chocochip119/wifi-csi-project/docs/members/README.md

# 팀원 기록

`member1.md`부터 `member7.md`까지는 역할/설계 메모/진행 상황을 적는 기존 템플릿입니다. 파일에 실명과 담당이 확정되어 있지 않아 이번 구조 정리에서 번호별 역할이나 완료 상태를 임의로 채우지 않았습니다.

| 템플릿 | 현재 상태 |
|---|---|
| [Member 1](member1.md) | 담당 미기입 |
| [Member 2](member2.md) | 담당 미기입 |
| [Member 3](member3.md) | 담당 미기입 |
| [Member 4](member4.md) | 담당 미기입 |
| [Member 5](member5.md) | 담당 미기입 |
| [Member 6](member6.md) | 담당 미기입 |
| [Member 7](member7.md) | 담당 미기입 |

각 기록에는 실제 작업 경로, PR/commit, 수행한 테스트와 남은 확인 항목을 함께 적습니다. 공통 시스템/규격은 [문서 목록](../README.md)에서 참조하고 팀원 문서마다 같은 구조 그림을 반복하지 않습니다. 현재 코드별 역할은 [저장소 구조](../repository_structure.md)를 참고하세요.
