chocochip119/wifi-csi-project/docs/members/member1.md

# Member 1

## 담당
- TBD

## 조사 / 설계 메모
-

## 진행 상황
- [ ] 담당 확정
- [ ] 입력/출력 정의
- [ ] 구현
- [ ] 검증

## 이슈 / TODO
-
