chocochip119/wifi-csi-project/docs/assets/presentation-pose-reference.jpg

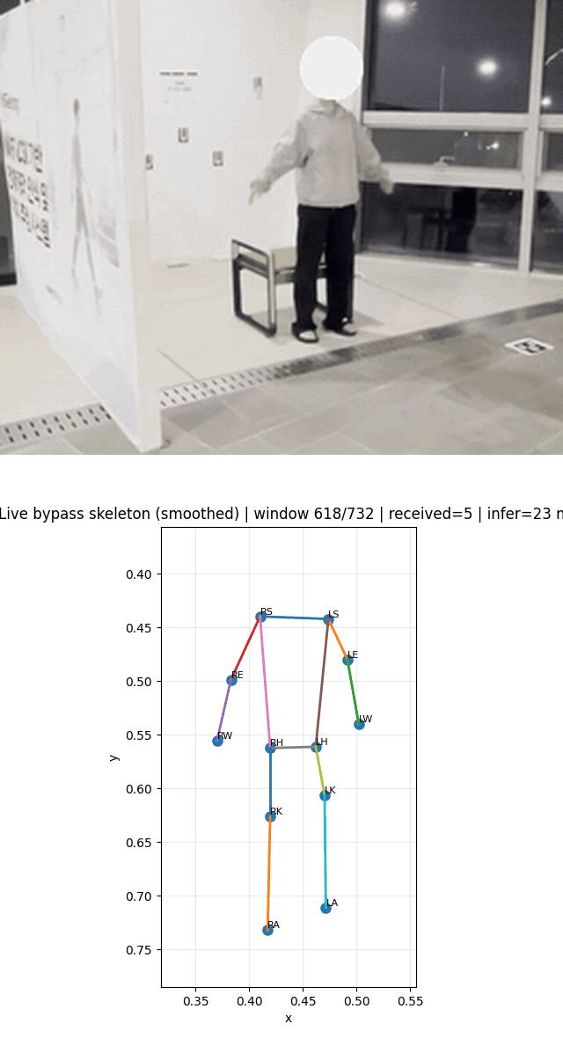
docs/assets/presentation-pose-reference.jpg
