chocochip119/wifi-csi-project/ml/localization/results/run_20261008_091144_37cf3fcf/knn_per_point_metrics.csv

point | precision | recall
p01 | 1.0 | 1.0
p02 | 0.9 | 1.0
p03 | 1.0 | 0.3333333333333333
p04 | 1.0 | 0.9315068493150684
p05 | 0.6956521739130435 | 0.64
p06 | 0.9827586206896551 | 0.7702702702702703
p07 | 0.9230769230769231 | 1.0
p08 | 0.9864864864864865 | 1.0
p09 | 0.5 | 1.0
p10 | 0.8548387096774194 | 0.7162162162162162
empty | 0.8409090909090909 | 1.0
