chocochip119/wifi-csi-project/ml/localization/results/run_20261008_091144_37cf3fcf/mlp_per_point_metrics.csv

point | precision | recall
p01 | 1.0 | 1.0
p02 | 0.9113924050632911 | 1.0
p03 | 0.8181818181818182 | 0.75
p04 | 1.0 | 1.0
p05 | 0.6578947368421053 | 1.0
p06 | 1.0 | 0.43243243243243246
p07 | 1.0 | 1.0
p08 | 0.9240506329113924 | 1.0
p09 | 0.40625 | 1.0
p10 | 1.0 | 0.7027027027027027
empty | 0.9736842105263158 | 1.0
