chocochip119/wifi-csi-project/ml/localization/results/run_20261008_091144_37cf3fcf/knn_confusion_matrix.csv

truth | p01 | p02 | p03 | p04 | p05 | p06 | p07 | p08 | p09 | p10 | empty
p01 | 24 | 0 | 0 | 0 | 0 | 0 | 0 | 0 | 0 | 0 | 0
p02 | 0 | 72 | 0 | 0 | 0 | 0 | 0 | 0 | 0 | 0 | 0
p03 | 0 | 0 | 8 | 0 | 0 | 0 | 2 | 1 | 13 | 0 | 0
p04 | 0 | 0 | 0 | 68 | 4 | 1 | 0 | 0 | 0 | 0 | 0
p05 | 0 | 0 | 0 | 0 | 16 | 0 | 0 | 0 | 0 | 9 | 0
p06 | 0 | 0 | 0 | 0 | 0 | 57 | 0 | 0 | 13 | 0 | 4
p07 | 0 | 0 | 0 | 0 | 0 | 0 | 24 | 0 | 0 | 0 | 0
p08 | 0 | 0 | 0 | 0 | 0 | 0 | 0 | 73 | 0 | 0 | 0
p09 | 0 | 0 | 0 | 0 | 0 | 0 | 0 | 0 | 26 | 0 | 0
p10 | 0 | 8 | 0 | 0 | 3 | 0 | 0 | 0 | 0 | 53 | 10
empty | 0 | 0 | 0 | 0 | 0 | 0 | 0 | 0 | 0 | 0 | 74
