chocochip119/wifi-csi-project/(commit log)

2026-09-15 fix: update ESP-TX IDF config and Wi-Fi bandwidth
    [main.c]
2026-09-25 feat(cnn): add CNN Encoder RTL
    Conv_MAC (16-lane, Conv1/Conv2 sequencer), requant_stage, gelu_stage,
    Pool (AdaptiveAvgPool 8x4 + requant), Buffer, and CNN_Encoder top.
    enc_start runs RX0 -> RX1 -> RX2; Pool result is stored at
    rx*1024 + oc*32 + oh*4 + ow.
2026-09-25 feat(cnn): add CNN Encoder testbenches and timescale
    - Add `timescale 1ns / 1ps to Pool.v and gelu_stage.v (Buffer.v already had it)
    - Add testbenches under pl/cnn/testbench/CNN_Encoder:
    tb_requant_stage (5,000 vectors), tb_Conv_MAC (184,320 acc outputs, 3 RX),
    tb_CNN_Encoder (full Conv1 -> Conv2 -> Pool, 3,072 B vs int8 reference)
    - Python vector generators follow ML/src/int8_reference.py rounding rules
2026-09-26 feat(cnn): add Flatten and FC FIFO RTL
    - Add Flatten interface between CNN Encoder output and FC module
    - Add 64-bit read path for FC activation data
    - Add FC FIFO for buffering activation data
    - Define fixed 1-cycle read latency between Flatten and FC
    [fc_fifo.v, flatten.v]
2026-09-29 fix(cnn): make Buffer infer BRAM for 64-bit write / 8-bit read
    Address the narrow cells as {waddr, lsb} instead of waddr * RATIO + i so
    Vivado recognizes one wide-port write (UG901 asymmetric RAM template).
    The old form was seen as RATIO independent write ports and failed with
    [Synth 8-3391]. Old code is kept as a comment.
    [Buffer.v]
2026-09-29 fix(cnn): add pipeline to fix timing slack
    Split long combinational paths so CNN_Encoder meets 100 MHz
    (XC7Z010, OOC place & route: WNS -2.99 ns -> +0.109 ns).
    - requant_stage: round shift | saturate
    - Pool: round shift | saturate, /48 (dq) | sign + clamp
    - Conv_MAC: 8x8 multiply (prod_r) | accumulate, add s3 tap stage
    Results are unchanged (tb_Conv_MAC, tb_CNN_Encoder pass); only latency
    increases, and valid/tag are delayed with the data.
    [Conv_MAC.v, Pool.v, requant_stage.v]
2026-09-29 docs: simplify README for current project scope
2026-09-29 fix: resolve FC pipeline review issues
    - Fix FC parameter addressing to use acc_tag
    - Correct negative requantization rounding
    - Reject invalid fc_sel values in FC controller
    [fc_controller.v, fc_top.v, requant_core.v]
2026-09-29 feat(cnn): parameterize CNN Encoder by number of receivers (RX)
    - CNN_Encoder: parameter RX (default 5); input buffer size, in_waddr,
    feat_raddr and tag width are derived from RX
    - Conv_MAC: rx counter width, last-RX check, input channel = rx + RX*ic
    - Pool: tag rx field, result memory RX*128 words, enc_done at rx == RX-1
    - requant_stage, gelu_stage: TAG_W parameter (tag is passed through)
    - Comments translated to English
    - tb_CNN_Encoder / gen_CNN_Encoder.py take RX; verified for RX = 1..5
    (tb_Conv_MAC, tb_requant_stage unchanged and still pass)
2026-09-29 fix: RX 지원 범위 제한 및 reset 방식 통일
    [pose_cnn.v, pose_cnn_ctrl.v]
2026-09-29 refactor: Loader RTL 디렉터리 구조 정리
2026-10-04 feat: stabilize ESP-TX timing and add 6-person training notebooks
    - set default Wi-Fi channel to 9
    - improve TX timeout and cycle pacing handling
    - add USB control age limit
    - add 6-person 5RX training notebooks
    [main.c]
2026-10-04 fix: address TX and FPGA export review issues
    - count only stale cycle frames as USB cycle drops
    - fix training notebook stride description
    - pin reference repository commit for reproducibility
    - validate exact FPGA weight blob region sizes
    [main.c]
2026-10-06 fix: correct requantization shift and pipeline handling
    - align requant parameters with accumulator pipeline
    - widen intermediate signals to prevent signed overflow
    - handle signed shift and saturation safely
    - preserve tag and valid timing through pipeline
    [requant_core.v]
2026-10-06 fix: align FC requant params and signed rounding
    [requant_core.v]
2026-10-06 fix: sync packaged requant core implementation
    [requant_core.v]
2026-10-07 fix: align requant parameters and rounding
    [requant_core.v]
2026-10-07 UDP
    pc로 udp 통신이 가능하게 ps 코드를 수정함
2026-10-07 Pin Colab to corrected INT8 reference and add reproducible golden checks
    [run_regression.py]
2026-10-07 파일 정리
2026-10-08 feat(localization): add location model training code and update backend model (#35)
    * feat(localization): add location ML code, rename to location_*, update model to 10/08 run
    - ml/localization: 11-class location training/eval code, notebook (outputs cleared), 60 unit tests,
    setup scripts, live check GUI (USB) + tools/csi_live_gui_ethernet.py (PS TCP 5000)
    - export_portable_model.py: run -> pc/backend npz/json + fixture; npz == sklearn on all 563 validation windows
    - pc/backend: fivepoint_{core,live,model} -> location_* (imports only)
    - pc/backend model: run_20261008_091144_37cf3fcf (Ridge, val BA 0.962); fixture covers all 11 classes
    - pc/backend/tools/replay_ps_server.py: fake PS replay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
    [knn_confusion_matrix.csv, knn_per_point_metrics.csv, leaderboard.csv, mlp_confusion_matrix.csv, mlp_per_point_metrics.csv, ridge_confusion_matrix.csv, ridge_per_point_metrics.csv]
2026-10-09 feat(frontend): expose side camera and pose mirror adjustments in settings
2026-10-09 Fix typo in RUN_README.md regarding thread usage
2026-10-09 fix(frontend): initialize launcher exit button after rendering main screen
2026-10-10 feat: WiSensing LIVE 위치/모션 모드와 관리자 진단 v18
    * feat(frontend): add live center/follow switching and location/pose admin metrics
    * fix(frontend): sync center/follow buttons on all LIVE reset
2026-10-10 feat: WiSensing 통합 관리자 및 실시간 12관절-캐릭터 연동
    * feat(frontend): enable live leg pose tracking by default
    * feat(frontend): unify pose input for skeleton and 3D rig; open administrator
    * feat(frontend): add 16 editable 12-joint pose presets and interpolation utilities
    * feat(admin): live/test pose editor with dragging, keyframes, replay and JSON IO
    * feat(admin): integrate live status, joint editing controls and 3D preview
    * fix(admin): show interpreted joint angles and support arbitrary real CNN coordinate scale
2026-10-10 feat: WiSensing 인체 구조 기반 2-Bone IK 및 앉기/몸통 보정
    * feat(ik): add reusable human joint constraints and seated-depth geometry
    * feat(rig): anatomical planted-seat IK, stable body offsets and chest-aware arm correction
    * feat(admin): expose anatomical IK calibration and 3D telemetry
    * fix(rig): smooth first chest-clearance IK frame from original arm rotation
2026-10-10 feat(ui): limit 3D foot spacing to pelvis width (#45)
    * feat(ui): constrain live foot spacing to pelvis width
    * feat(ui): track foot spacing even without other leg activity
    * feat(ui): add hip-width-capped planted foot IK
    * test(ui): verify pelvis-width foot stance bounds and mirror safety
    * fix(ui): preserve procedural seated fallback when stance tracking is idle
2026-10-10 refactor(ui): export testable arm activity classifier
2026-10-10 refactor(ui): use shared arm activity classifier
2026-10-10 test(ui): cover neutral and raised arm tracking
2026-10-10 chore(esp32): remove legacy rx/tx folders; keep dataset_collecter ESP-RX/ESP-TX (#51)
    - remove esp32/rx (old COM text tools: csi_test.py, wave.py) and esp32/tx placeholder
    - current firmware stays in esp32/dataset_collecter/ESP-TX, ESP-RX
    - update esp32/README.md and docs/repository_structure.md
2026-10-11 chore(esp32): move ESP-RX/ESP-TX out of dataset_collecter (#54)
2026-10-11 fix(ui): add missing leg IK and foot rotation modules
2026-10-11 fix: track updated Ridge localization model
2026-10-11 feat: track final RX5 FPGA CNN weights
2026-10-12 feat: add FPS monitoring and improve pose tracking with zone-based arm limits
2026-10-12 feat(ps_location): add PS-side location inference trial folder (#66)
    확정 전 시험 폴더. 기존 ps/, pc/backend/는 변경 없음.
    - PS C 위치 엔진(loc_ridge.c): 전처리~Ridge 추론, PC Python과 parity 확인
    - PS→PC TCP 5000 단일 포트, Location(type 5) 추가
    - 위치 모델: run_20261012_155827_3b82163c (Ridge)
    - 보드 실행/PetaLinux 빌드는 미확인
2026-10-13 fix: improve single-leg tracking and prevent seated leg jitter
2026-10-13 fix(ui): track continuous 5-second motion absence
2026-10-13 fix(ui): 3 switches modes, 5-second motion absence, mirrored screen visuals
2026-10-13 docs(frontend): explain 3-key mode switch, presence delay, visual mirroring
2026-10-13 style(frontend): add compact accessible L/R pose toggle button
2026-10-13 test(frontend): verify paired mirror, nonmutation and symmetric leg metrics
2026-10-13 docs(frontend): explain mirrored viewer poses and fallback L/R button
2026-10-13 fix(frontend): release lifted-foot IK anchors when switching pose sides
2026-10-13 feat(ui): restrict single-leg lift to P05/P10 with bounded raised-foot angle
2026-10-13 fix(frontend): veto false seated state on clearly unilateral leg lift including P10
2026-10-13 test(frontend): only P05/P10 permits low-angle single-leg motion
2026-10-13 test(frontend): suppress false sitting caused by clear single-leg motion
2026-10-13 test(frontend): bounded lifted-foot pitch and outward rotation
2026-10-13 fix(frontend): block raw leg-angle lifts outside P05/P10 even without planted stance
2026-10-13 docs(ui): explain P05/P10-only limited leg lift and unilateral P10 sit veto
2026-10-13 fix(ui): allow unrestricted leg lift at P05/P10 and 10-degree cap elsewhere
2026-10-13 docs(ui): correct leg lift rule P05/P10 unrestricted and other positions 10 degrees
2026-10-13 fix(ui): use exact zero yaw for neutral lifted foot
2026-10-13 docs: explain esp32/README.md by role, implemented features and detailed links
2026-10-13 docs: describe implemented end-to-end system and distinguish PC/PS/PL location flows
2026-10-13 docs: polish subsection flow in pc/frontend/README.md
2026-10-13 docs: polish subsection flow in pc/backend/README.md
2026-10-13 docs: polish subsection flow in pl/README.md
2026-10-13 feat(ps_location): update location Ridge model to run_20261013_122537 (#78)
    - 검증 창 267개: sklearn 대비 점수 차이 0, 라벨 불일치 0 (검증 정확도 0.9925)
    - 실제 검증 CSI 40창: PS C 엔진 라벨 40/40 일치
2026-10-14 feat(frontend): viewer walk skeleton and bilateral leg geometry helpers
2026-10-14 feat(frontend): latch squat/lift/stand after consecutive joint frames with minimum holds
2026-10-14 fix(ui): neutral pose gate and smooth confirmed limb motion instead of instant switches
2026-10-14 fix(ui): retain lifted leg side until stable state changes
2026-10-14 fix(ui): keep confirmed lift strength/side stable across noisy 2D frames
2026-10-14 fix(ui): reject unconfirmed raw leg lift while stable posture is standing
2026-10-14 test(frontend): movement zone, walking skeleton and multi-frame posture stability
2026-10-14 fix(frontend): preserve leg-lift sample and neutral unavailable posture
2026-10-14 fix(frontend): restore active filtered/custom/replay 2D frame after walking
2026-10-14 fix(ps): automatically re-arm TX after fifth RX joins a 4/5 RUN snapshot
2026-10-14 fix(ui): distinguish TX RUN snapshot slots from all RX LIVE flags
2026-10-14 test(backend): preserve five-slot gating when STATUS shows five live rows but RUN 4/5
2026-10-19 fix(ps): reuse SD boot partition already mounted by PetaLinux
